intergalaktik/ulx5m-gs/(notices)

Notices in the files:
parts and their libraries:
project_license: CERN-OHL-S v2
